isomatter-labs/pulse/README.md

# pulse
A simple power supply / battery box / UPS for many applications.
