isomatter-labs/pulse/pulse-bom.ods

Sheet: Configuration Lookup
 |  |  |  |  |  |  | Assembly fee pct: | 50.00% |  |  | USB Port | Charging Circuit | 3v3 Regulator | 5v regulator | 12v regualtor | 24v regulator
 |  |  |  |  |  |  | Overhead pct: | 50.00% |  | Pulse- | U | C | 3 | 5 | 1 | 2
 |  |  |  |  |  |  | Shipping $: | 3
 |  |  |  |  |  |  |  | with assembly fee | with shipping only
pulse- |  |  |  |  |  | 2 | 2.439563333333333 | 8.4890175 | 6.659345
pulse- |  |  |  |  | 1 |  | 2.439563333333333 | 8.4890175 | 6.659345
pulse- |  |  |  |  | 1 | 2 | 2.870876666666666 | 9.4594725 | 7.306315
pulse- |  |  |  | 5 |  |  | 2.439563333333333 | 8.4890175 | 6.659345
pulse- |  |  |  | 5 |  | 2 | 2.870876666666666 | 9.4594725 | 7.306315
pulse- |  |  |  | 5 | 1 |  | 2.870876666666666 | 9.4594725 | 7.306315
pulse- |  |  |  | 5 | 1 | 2 | 3.30219 | 10.4299275 | 7.953285
pulse- |  |  | 3 |  |  | 2 | 2.866284166666667 | 9.449139375 | 7.29942625
pulse- |  |  | 3 |  | 1 |  | 2.866284166666667 | 9.449139375 | 7.29942625
pulse- |  |  | 3 |  | 1 | 2 | 3.2975975 | 10.419594375 | 7.94639625
pulse- |  |  | 3 | 5 |  |  | 2.866284166666667 | 9.449139375 | 7.29942625
pulse- |  |  | 3 | 5 |  | 2 | 3.2975975 | 10.419594375 | 7.94639625
pulse- |  |  | 3 | 5 | 1 |  | 3.2975975 | 10.419594375 | 7.94639625
pulse- |  |  | 3 | 5 | 1 | 2 | 3.728910833333333 | 11.390049375 | 8.59336625
pulse- |  | C |  |  |  | 2 | 3.076203333333333 | 9.9214575 | 7.614305
pulse- |  | C |  |  | 1 |  | 3.076203333333333 | 9.9214575 | 7.614305
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
pulse- | U | C | 3 | 5 |  | 2 | 4.027703499999999 | 12.062332875 | 9.04155525
pulse- | U | C | 3 | 5 | 1 |  | 4.027703499999999 | 12.062332875 | 9.04155525
pulse- | U | C | 3 | 5 | 1 | 2 | 4.459016833333333 | 13.032787875 | 9.68852525

Sheet: Configuration
All Configs |  |  |  | V varies wildly with qty | 2.00825
PCB |  |  |  | 2
J4 | 1x5 | 2.54mm Male | 1x5_2.54mm Male | 0.00825
USB Port |  |  |  |  | 0.093466
F1 | 1.5A | 0805 | 1.5A_0805 | 0.08399999999999999
R1 | 5k1 | 0805 | 5k1_0805 | 0.002258
R2 | 5k1 | 0805 | 5k1_0805 | 0.002258
J1 | 1x1 | 2.54mm Male | 1x1_2.54mm Male | 0.00165
J2 | 1x1 | 2.54mm Male | 1x1_2.54mm Male | 0.00165
J3 | 1x1 | 2.54mm Male | 1x1_2.54mm Male | 0.00165
Battery Charger |  |  |  |  | 0.63664
U1 | BQ2409X | MSOP-10-EP | BQ2409X_MSOP-10-EP | 0.6
C1 | 1u | 0805 | 1u_0805 | 0.01311
R3 | 540R | 0805 | 540R_0805 | 0.002258
R4 | 2k | 0805 | 2k_0805 | 0.002258
R5 | 100k | 0805 | 100k_0805 | 0.002258
R6 | 1k5 | 0805 | 1k5_0805 | 0.002258
R7 | 1k5 | 0805 | 1k5_0805 | 0.002258
D1 | Red | 1206 | Red_1206 | 0.005653333333333334
D2 | Blue | 1206 | Blue_1206 | 0.006586666666666667
3v3 Regulator
U2 | 34063 | SOIC-8 | 34063_SOIC-8 | 0.0504 | 0.4267208333333333
Q1 | PMOS 3A | GSD SOT-23 | PMOS 3A_ GSD SOT-23 | 0.012960000000000001
C2 | 100uF 6v | 1206 | 100uF 6v_1206 | 0.0378
C6 | 470pF | 0805 | 470pF_0805 | 0.0089675
C10 | 470uF 35v | 10mm 5mm radial | 470uF 35v_10mm 5mm radial | 0.07200000000000001
R8 | 10k | 0805 | 10k_0805 | 0.002258
R9 | 1k | 0805 | 1k_0805 | 0.002258
R16 | 0R22 1.5A | 0805 | 0R22 1.5A_0805 | 0.004
R26 | 5k6 | 0805 | 5k6_0805 | 0.002258
R27 | 3k3 | 0805 | 3k3_0805 | 0.002258
L4 | 220uH 1.5A | SRR1280 | 220uH 1.5A_SRR1280 | 0.162
D3 | 1.5A Schottky | SOD-123F | 1.5A Schottky_SOD-123F | 0.06
J9 | 1x1 | 2.54mm Male | 1x1_2.54mm Male | 0.00165
R31 | 1k | 0805 | 1k_0805 | 0.002258
D10 | Red | 1206 | Red_1206 | 0.005653333333333334
5v Regulator
U3 | 34063 | SOIC-8 | 34063_SOIC-8 | 0.0504 | 0.4313133333333333
Q2 | PMOS 3A | GSD SOT-23 | PMOS 3A_ GSD SOT-23 | 0.012960000000000001
C3 | 100uF 6v | 1206 | 100uF 6v_1206 | 0.0378
C7 | 1500pf | 0805 | 1500pf_0805 | 0.013560000000000001
C11 | 470uF 35v | 10mm 5mm radial | 470uF 35v_10mm 5mm radial | 0.07200000000000001
R10 | 10k | 0805 | 10k_0805 | 0.002258
R11 | 1k | 0805 | 1k_0805 | 0.002258
R17 | 0R22 1.5A | 0805 | 0R22 1.5A_0805 | 0.004
R20 | 10k | 0805 | 10k_0805 | 0.002258
R21 | 3k3 | 0805 | 3k3_0805 | 0.002258
L1 | 220uH 1.5A | SRR1280 | 220uH 1.5A_SRR1280 | 0.162
D4 | 1.5A Schottky | SOD-123F | 1.5A Schottky_SOD-123F | 0.06
J12 | 1x1 | 2.54mm Male | 1x1_2.54mm Male | 0.00165
R30 | 1k5 | 0805 | 1k5_0805 | 0.002258
D9 | Red | 1206 | Red_1206 | 0.005653333333333334
12v Regulator
U4 | 34063 | SOIC-8 | 34063_SOIC-8 | 0.0504 | 0.4313133333333333
Q3 | PMOS 3A | GSD SOT-23 | PMOS 3A_ GSD SOT-23 | 0.01296
C4 | 100uF 6v | 1206 | 100uF 6v_1206 | 0.0378
C8 | 1500pf | 0805 | 1500pf_0805 | 0.01356
C12 | 470uF 35v | 10mm 5mm radial | 470uF 35v_10mm 5mm radial | 0.072
R12 | 10k | 0805 | 10k_0805 | 0.002258
R13 | 1k | 0805 | 1k_0805 | 0.002258
R18 | 0R22 1.5A | 0805 | 0R22 1.5A_0805 | 0.004
R22 | 30k | 0805 | 30k_0805 | 0.002258
R23 | 3k3 | 0805 | 3k3_0805 | 0.002258
L2 | 220uH 1.5A | SRR1280 | 220uH 1.5A_SRR1280 | 0.162
D5 | 1.5A Schottky | SOD-123F | 1.5A Schottky_SOD-123F | 0.06
J10 | 1x1 | 2.54mm Male | 1x1_2.54mm Male | 0.00165
R28 | 3k3 | 0805 | 3k3_0805 | 0.002258
D7 | Red | 1206 | Red_1206 | 0.0056533333333333
24v Regulator
U5 | 34063 | SOIC-8 | 34063_SOIC-8 | 0.0504 | 0.4313133333333333
Q4 | PMOS 3A | GSD SOT-23 | PMOS 3A_ GSD SOT-23 | 0.01296
C5 | 100uF 6v | 1206 | 100uF 6v_1206 | 0.0378
C9 | 1500pf | 0805 | 1500pf_0805 | 0.01356
C13 | 470uF 35v | 10mm 5mm radial | 470uF 35v_10mm 5mm radial | 0.072
R14 | 10k | 0805 | 10k_0805 | 0.002258
R15 | 1k | 0805 | 1k_0805 | 0.002258
R19 | 0R22 1.5A | 0805 | 0R22 1.5A_0805 | 0.004
R24 | 56k | 0805 | 56k_0805 | 0.002258
R25 | 3k | 0805 | 3k_0805 | 0.002258
L3 | 220uH 1.5A | SRR1280 | 220uH 1.5A_SRR1280 | 0.162
D6 | 1.5A Schottky | SOD-123F | 1.5A Schottky_SOD-123F | 0.06
J11 | 1x1 | 2.54mm Male | 1x1_2.54mm Male | 0.00165
R29 | 6k8 | 0805 | 6k8_0805 | 0.002258
D8 | Red | 1206 | Red_1206 | 0.0056533333333333

Sheet: Part Table
part | unit cost | min cost | comes with | link
1x5_2.54mm Male | 0.00825 | 0.66 | 80 | https://www.aliexpress.com/item/32963302159.html
1x1_2.54mm Male | 0.00165 | 0.66 | 400 | https://www.aliexpress.com/item/32963302159.html
1.5A_0805 | 0.084 | 1.68 | 20 | https://www.aliexpress.com/item/4000233270360.html
100k_0805 | 0.002258 | 11.29 | 5000 | https://www.aliexpress.com/item/4000569518897.html
2k_0805 | 0.002258 | 11.29 | 5000 | https://www.aliexpress.com/item/4000569518897.html
5k1_0805 | 0.002258 | 11.29 | 5000 | https://www.aliexpress.com/item/4000569518897.html
540R_0805 | 0.002258 | 11.29 | 5000 | https://www.aliexpress.com/item/4000569518897.html
1k5_0805 | 0.002258 | 11.29 | 5000 | https://www.aliexpress.com/item/4000569518897.html
10k_0805 | 0.002258 | 11.29 | 5000 | https://www.aliexpress.com/item/4000569518897.html
1k_0805 | 0.002258 | 11.29 | 5000 | https://www.aliexpress.com/item/4000569518897.html
5k6_0805 | 0.002258 | 11.29 | 5000 | https://www.aliexpress.com/item/4000569518897.html
3k3_0805 | 0.002258 | 11.29 | 5000 | https://www.aliexpress.com/item/4000569518897.html
BQ2409X_MSOP-10-EP | 0.6 | 3 | 5 | https://www.aliexpress.com/item/32809893346.html
1u_0805 | 0.01311 | 26.22 | 2000 | https://www.aliexpress.com/item/32998534731.html
Red_1206 | 0.0056533333333 | 16.96 | 3000 | https://www.aliexpress.com/item/32981589685.html
Blue_1206 | 0.0065866666667 | 19.76 | 3000 | https://www.aliexpress.com/item/32981589685.html
34063_SOIC-8 | 0.0504 | 5.04 | 100 | https://www.aliexpress.com/item/32328511770.html
PMOS 3A_ GSD SOT-23 | 0.01296 | 38.88 | 3000 | https://www.aliexpress.com/item/33025865729.html
100uF 6v_1206 | 0.0378 | 3.78 | 100 | https://www.aliexpress.com/item/32880416347.html
470pF_0805 | 0.0089675 | 35.87 | 4000 | https://www.aliexpress.com/item/32998534731.html
470uF 35v_10mm 5mm radial | 0.072 | 7.2 | 100 | https://www.aliexpress.com/item/32526581314.html
0R22 1.5A_0805 | 0.004 | 20 | 5000 | https://www.aliexpress.com/item/32839944752.html
220uH 1.5A_SRR1280 | 0.162 | 1.62 | 10 | https://www.aliexpress.com/item/4000167007649.html
1.5A Schottky_SOD-123F | 0.06 | 6 | 100 | https://www.aliexpress.com/item/32254433042.html
1500pf_0805 | 0.01356 | 54.24 | 4000 | https://www.aliexpress.com/item/33000119708.html
56k_0805 | 0.002258 | 11.29 | 5000 | https://www.aliexpress.com/item/4000569518897.html
3k_0805 | 0.002258 | 11.29 | 5000 | https://www.aliexpress.com/item/4000569518897.html
6k8_0805 | 0.002258 | 11.29 | 5000 | https://www.aliexpress.com/item/4000569518897.html
30k_0805 | 0.002258 | 11.29 | 5000 | https://www.aliexpress.com/item/4000569518897.html

Sheet: digikey
Total @1k | 15.23878 | Total @1 | 32.03 | How many regulators? (rough cost overest) | 4
 | Value | cost at 1k | Cost at 1 | Qty | Line Cost @1k | Line Cost @1 | Link
PCB |  | 0.362 | 3.62 | 1 | 0.362 | 3.62 | https://cart.jlcpcb.com/quote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
BT1 | 18650 button cell | 5.95 | 5.95 | 1 | 5.95 | 5.95 | https://www.digikey.com/product-detail/en/tinycircuits/ASR00050/1832-1050-ND/9808766
C1 | 1u | 0.01579 | 0.1 | 1 | 0.01579 | 0.1 | https://www.digikey.com/product-detail/en/samsung-electro-mechanics/CL21B105KOFNNNG/1276-6471-1-ND/5958099
> C2-C5 | CL31A107MQHNNNE | 0.16989 | 0.58 | 4 | 0.67956 | 2.32 | https://www.digikey.com/product-detail/en/samsung-electro-mechanics/CL31A107MQHNNNE/1276-1782-1-ND/3889868
C6 | 470pF | 0.01319 | 0.1 | 1 | 0.01319 | 0.1 | https://www.digikey.com/product-detail/en/samsung-electro-mechanics/CL21B471KBANNNC/1276-1300-1-ND/3889386
> C7-C9 | 1500pF | 0.01355 | 0.1 | 3 | 0.04065 | 0.3 | https://www.digikey.com/product-detail/en/samsung-electro-mechanics/CL21B152KBANNNC/1276-1794-1-ND/3889880
> C10-C13 | 470uF | 0.154 | 0.45 | 4 | 0.616 | 1.8 | https://www.digikey.com/product-detail/en/panasonic-electronic-components/ECA-1VM471/P5168-ND/245027
D1 | Power Good LED | 0.1 | 0.3 | 1 | 0.1 | 0.3
D2 | Charging Active LED | 0.1 | 0.3 | 1 | 0.1 | 0.3
> D3-D6 | NRVTS260ESFT3G | 0.07268 | 0.34 | 4 | 0.29072 | 1.36 | https://www.digikey.com/product-detail/en/on-semiconductor/NRVTS260ESFT3G/NRVTS260ESFT3GOSCT-ND/9087444
D7 | 12v LED | 0.1 | 0.3 | 1 | 0.1 | 0.3
D8 | 24v LED | 0.1 | 0.3 | 1 | 0.1 | 0.3
D9 | 5v LED | 0.1 | 0.3 | 1 | 0.1 | 0.3
D10 | 3v3 LED | 0.1 | 0.3 | 1 | 0.1 | 0.3
F1 | 1.5A | 0.17784 | 0.33 | 1 | 0.17784 | 0.33 | https://www.digikey.com/product-detail/en/bel-fuse-inc/0ZCK0100FF2E/507-1815-1-ND/4156258
J1-J3, J5-J12 | 2.54mm header 1x1 | 0.01486 | 0.03 | 11 | 0.16346 | 0.33 | https://www.digikey.com/product-detail/en/sullins-connector-solutions/PREC001SAAN-RC/S1012EC-01-ND/2774853
J4 | 2.54mm header 1x5 | 0.04009 | 0.1 | 1 | 0.04009 | 0.1 | https://www.digikey.com/product-detail/en/adam-tech/PH1-05-UA/2057-PH1-05-UA-ND/9830343
J13 | USB4085-GF-A_REVA | 0.9656 | 1.37 | 1 | 0.9656 | 1.37 | https://www.digikey.com/product-detail/en/gct/USB4085-GF-A/2073-USB4085-GF-ACT-ND/9859733
> L1-L4 | SRR1280-221K | 0.8378 | 1.25 | 4 | 3.3512 | 5 | https://www.digikey.com/product-detail/en/bourns-inc/SRR1280-221K/SRR1280-221KLCT-ND/2127436
> Q1-Q4 | DMP3099L-7 | 0.06969 | 0.33 | 4 | 0.27876 | 1.32 | https://www.digikey.com/product-detail/en/diodes-incorporated/DMP3099L-7/DMP3099L-7DICT-ND/5218217
> R1, R2 | 5k1 | 0.02 | 0.1 | 2 | 0.04 | 0.2
R3 | 540R | 0.02 | 0.1 | 1 | 0.02 | 0.1
R4 | 2k | 0.02 | 0.1 | 1 | 0.02 | 0.1
R5 | 100k | 0.02 | 0.1 | 1 | 0.02 | 0.1
> R6, R7, R30 | 1k5 | 0.02 | 0.1 | 3 | 0.06 | 0.3
> R8, R10, R12, R14, R20 | 10k | 0.02 | 0.1 | 5 | 0.1 | 0.5
> R9, R11, R13, R15, R31 | 1k | 0.02 | 0.1 | 5 | 0.1 | 0.5
> R16-R19 | 0R22 | 0.02 | 0.1 | 4 | 0.08 | 0.4
R22 | 29k | 0.02 | 0.1 | 1 | 0.02 | 0.1
R24 | 60k | 0.02 | 0.1 | 1 | 0.02 | 0.1
R26 | 5k6 | 0.02 | 0.1 | 1 | 0.02 | 0.1
> R21, R23, R25, R27, R28 | 3k3 | 0.02 | 0.1 | 5 | 0.1 | 0.5
R29 | 6k8 | 0.02 | 0.1 | 1 | 0.02 | 0.1
SW1 | Power Switch |  |  |  | 0 | 0
U1 | BQ2409X | 0.546 | 1.29 | 1 | 0.546 | 1.29 | https://www.digikey.com/product-detail/en/texas-instruments/BQ24092DGQR/296-41204-1-ND/5222660
> U2-U5 | MC34063AD | 0.13198 | 0.46 | 4 | 0.52792 | 1.84 | https://www.digikey.com/product-detail/en/diodes-incorporated/AZ34063UMTR-G1/AZ34063UMTR-G1DICT-ND/4505211
