isomatter-labs/pulse/pulse.kicad_pcb

## KiCad design pulse.kicad_pcb (2020-03-19)

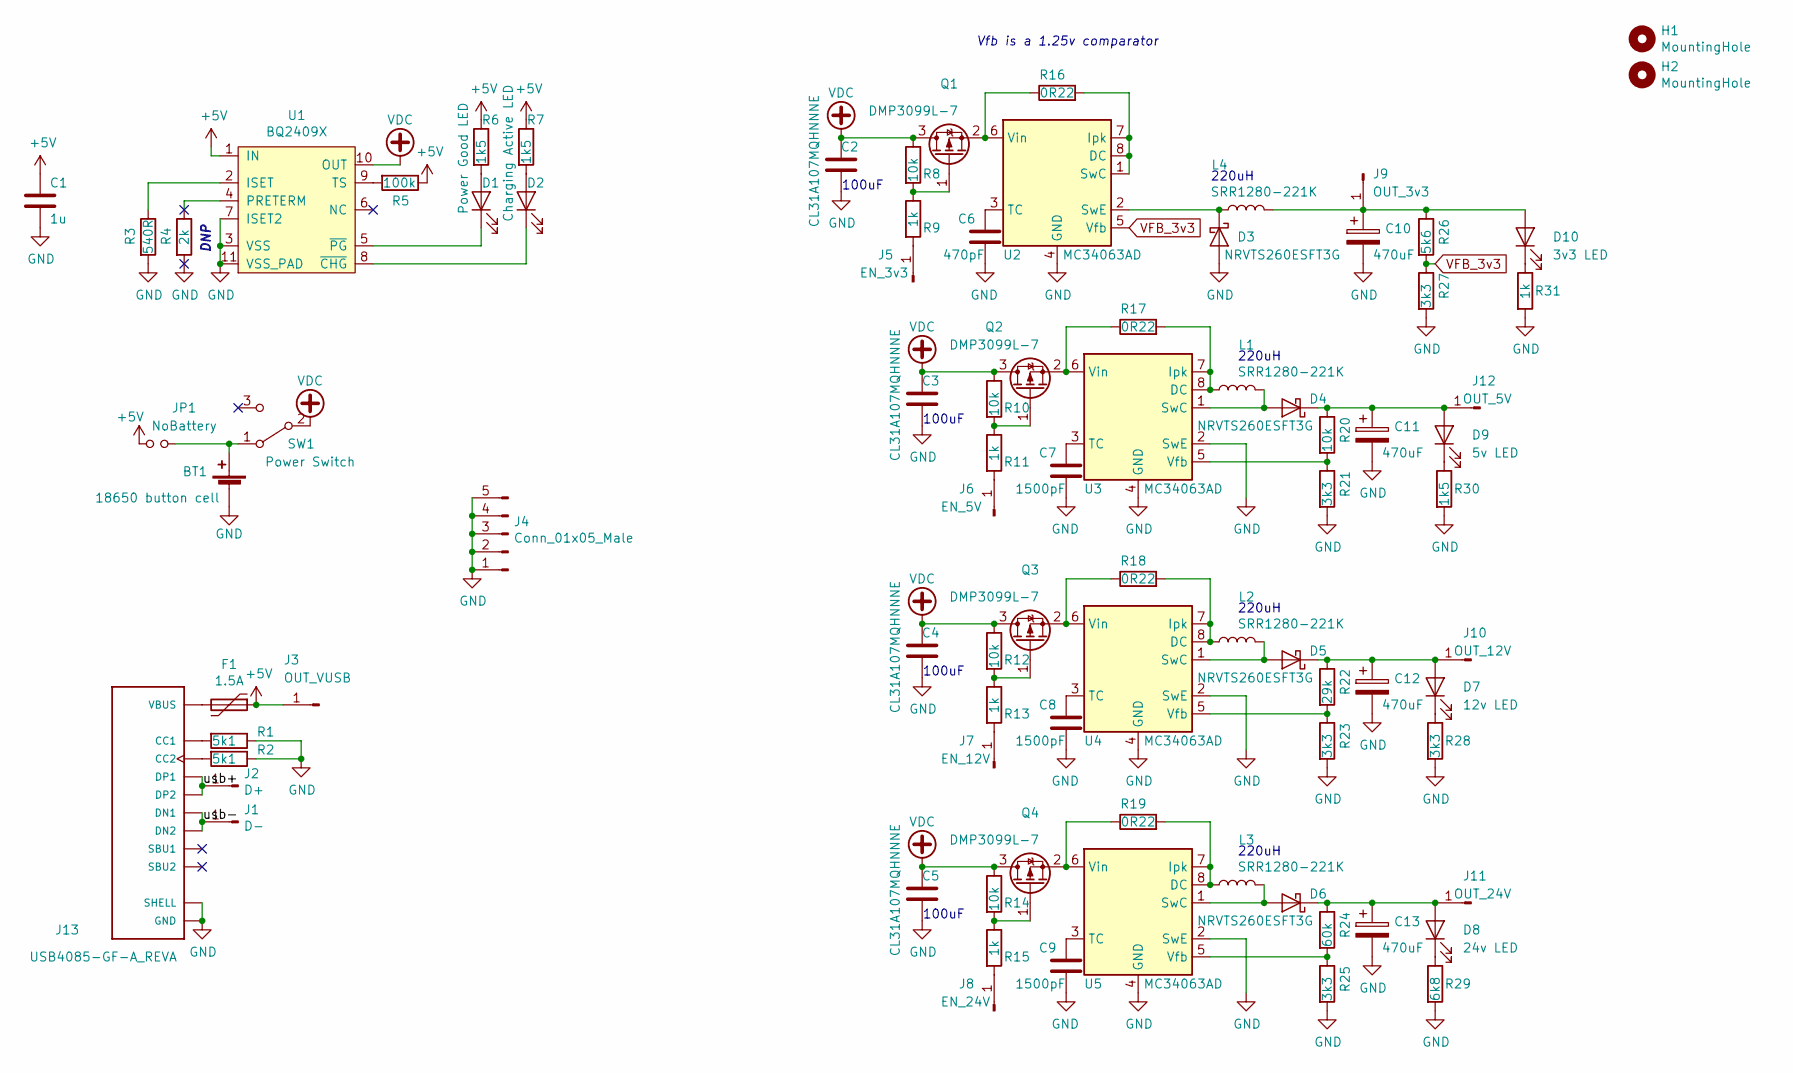
[picture p1: schematic pulse.sch]

Parts:
BT1: 18650 button cell; BatteryHolder_MPD_BH-18650-PC2
C1: 1u; C_0805_2012Metric
C2, C3, C4, C5: CL31A107MQHNNNE; C_1206_3216Metric
C6: 470pF; C_0805_2012Metric
C7, C8, C9: 1500pF; C_0805_2012Metric
C10, C11, C12, C13: 470uF; CP_Radial_D10.0mm_P5.00mm
D1: Power Good LED; LED_1206_3216Metric
D2: Charging Active LED; LED_1206_3216Metric
D3, D4, D5, D6: NRVTS260ESFT3G; D_SOD-123F
D7: 12v LED; LED_1206_3216Metric
D8: 24v LED; LED_1206_3216Metric
D9: 5v LED; LED_1206_3216Metric
D10: 3v3 LED; LED_1206_3216Metric
F1: 1.5A; C_0805_2012Metric
H1, H2: MountingHole; MountingHole_3.2mm_M3
J1: D-; PinHeader_1x01_P2.54mm_Vertical
J2: D+; PinHeader_1x01_P2.54mm_Vertical
J3: OUT_VUSB; PinHeader_1x01_P2.54mm_Vertical
J4: Conn_01x05_Male; PinHeader_1x05_P2.54mm_Vertical
J5: EN_3v3; PinHeader_1x01_P2.54mm_Vertical
J6: EN_5V; PinHeader_1x01_P2.54mm_Vertical
J7: EN_12V; PinHeader_1x01_P2.54mm_Vertical
J8: EN_24V; PinHeader_1x01_P2.54mm_Vertical
J9: OUT_3v3; PinHeader_1x01_P2.54mm_Vertical
J10: OUT_12V; PinHeader_1x01_P2.54mm_Vertical
J11: OUT_24V; PinHeader_1x01_P2.54mm_Vertical
J12: OUT_5V; PinHeader_1x01_P2.54mm_Vertical
J13: USB4085-GF-A_REVA; GCT_USB4085-GF-A_REVA
JP1: NoBattery; SolderJumper-2_P1.3mm_Open_Pad1.0x1.5mm
L1, L2, L3, L4: SRR1280-221K; L_Bourns_SRR1208
Q1, Q2, Q3, Q4: DMP3099L-7; SOT-23
R1, R2: 5k1; R_0805_2012Metric
R3: 540R; R_0805_2012Metric
R4: 2k; R_0805_2012Metric
R5: 100k; R_0805_2012Metric
R6, R7, R30: 1k5; R_0805_2012Metric
R8, R10, R12, R14, R20: 10k; R_0805_2012Metric
R9, R11, R13, R15, R31: 1k; R_0805_2012Metric
R16, R17, R18, R19: 0R22; R_1206_3216Metric
R21, R23, R25, R27, R28: 3k3; R_0805_2012Metric
R22: 29k; R_0805_2012Metric
R24: 60k; R_0805_2012Metric
R26: 5k6; R_0805_2012Metric
R29: 6k8; R_0805_2012Metric
SW1: Power Switch; PinHeader_1x03_P2.54mm_Vertical
U1: BQ2409X; MSOP-10-1EP_3x3mm_P0.5mm_EP1.68x1.88mm
U2, U3, U4, U5: MC34063AD; SOIC-8_3.9x4.9mm_P1.27mm

Connections:
+5V: C1.1, F1.1, J3.1, JP1.1, R5.1, R6.1, R7.1, U1.1 (IN)
/usb+: J2.1, J13.A6 (DP1), J13.B6 (DP2)
/usb-: J1.1, J13.A7 (DN1), J13.B7 (DN2)
GND: BT1.2 (-), C1.2, C2.2, C3.2, C4.2, C5.2, C6.2, C7.2, C8.2, C9.2, C10.2, C11.2, C12.2, C13.2, D3.2 (A), J4.1, J4.2, J4.3, J4.4, J4.5, J13.A1 (GND), J13.A12 (GND), J13.B1 (GND), J13.B12 (GND), J13.P1 (SHELL), J13.P2 (SHELL), J13.P3 (SHELL), J13.P4 (SHELL), R1.1, R2.1, R3.2, R4.2, R21.2, R23.2, R25.2, R27.2, R28.2, R29.2, R30.2, R31.2, U1.3 (VSS), U1.7 (ISET2), U1.11 (VSS_PAD), U2.4 (GND), U3.2 (SwE), U3.4 (GND), U4.2 (SwE), U4.4 (GND), U5.2 (SwE), U5.4 (GND)
unnamed: BT1.1 (+), JP1.2, SW1.1 (A)
unnamed: C6.1, U2.3 (TC)
unnamed: C7.1, U3.3 (TC)
unnamed: C8.1, U4.3 (TC)
unnamed: C9.1, U5.3 (TC)
unnamed: C10.1, D10.2 (A), J9.1, L4.2, R26.1
unnamed: C11.1, D4.1 (K), D9.2 (A), J12.1, R20.1
unnamed: C12.1, D5.1 (K), D7.2 (A), J10.1, R22.1
unnamed: C13.1, D6.1 (K), D8.2 (A), J11.1, R24.1
unnamed: D1.1 (K), U1.5 (~PG)
unnamed: D1.2 (A), R6.2
unnamed: D2.1 (K), U1.8 (~CHG)
unnamed: D2.2 (A), R7.2
unnamed: D3.1 (K), L4.1, U2.2 (SwE)
unnamed: D4.2 (A), L1.2, U3.1 (SwC)
unnamed: D5.2 (A), L2.2, U4.1 (SwC)
unnamed: D6.2 (A), L3.2, U5.1 (SwC)
unnamed: D7.1 (K), R28.1
unnamed: D8.1 (K), R29.1
unnamed: D9.1 (K), R30.1
unnamed: D10.1 (K), R31.1
unnamed: F1.2, J13.A4 (VBUS), J13.A9 (VBUS), J13.B4 (VBUS), J13.B9 (VBUS)
unnamed: J5.1, R9.2
unnamed: J6.1, R11.2
unnamed: J7.1, R13.2
unnamed: J8.1, R15.2
unnamed: J13.A5 (CC1), R1.2
unnamed: J13.B5 (CC2), R2.2
unnamed: L1.1, R17.2, U3.7 (Ipk), U3.8 (DC)
unnamed: L2.1, R18.2, U4.7 (Ipk), U4.8 (DC)
unnamed: L3.1, R19.2, U5.7 (Ipk), U5.8 (DC)
unnamed: Q1.1 (G), R8.2, R9.1
unnamed: Q1.2 (S), R16.1, U2.6 (Vin)
unnamed: Q2.1 (G), R10.2, R11.1
unnamed: Q2.2 (S), R17.1, U3.6 (Vin)
unnamed: Q3.1 (G), R12.2, R13.1
unnamed: Q3.2 (S), R18.1, U4.6 (Vin)
unnamed: Q4.1 (G), R14.2, R15.1
unnamed: Q4.2 (S), R19.1, U5.6 (Vin)
unnamed: R3.1, U1.2 (ISET)
unnamed: R4.1, U1.4 (PRETERM)
unnamed: R5.2, U1.9 (TS)
unnamed: R16.2, U2.1 (SwC), U2.7 (Ipk), U2.8 (DC)
unnamed: R20.2, R21.1, U3.5 (Vfb)
unnamed: R22.2, R23.1, U4.5 (Vfb)
unnamed: R24.2, R25.1, U5.5 (Vfb)
VDC: C2.1, C3.1, C4.1, C5.1, Q1.3 (D), Q2.3 (D), Q3.3 (D), Q4.3 (D), R8.1, R10.1, R12.1, R14.1, SW1.2 (B), U1.10 (OUT)
VFB_3v3: R26.2, R27.1, U2.5 (Vfb)

Notes on the sheet:
DNP
100uF
220uH
Vfb is a 1.25v comparator

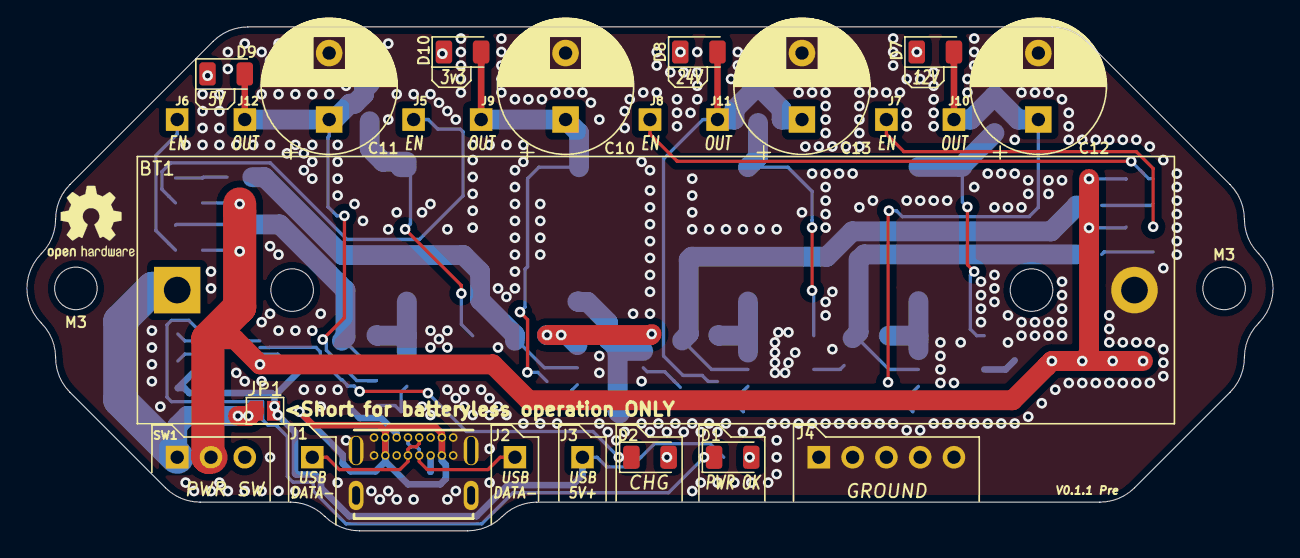
[picture p2: board pulse.kicad_pcb from above]

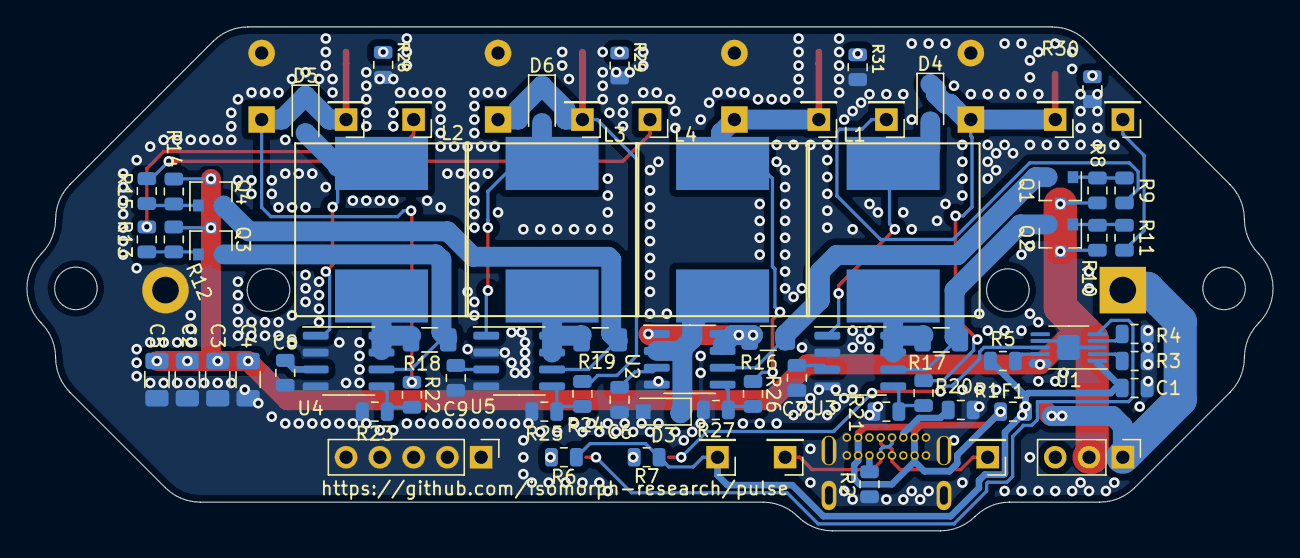
[picture p3: board pulse.kicad_pcb from below]

Board: 2 copper layers, 93.7 x 37.9 mm, 86 parts (71 on the bottom side), 52 nets.
