isomatter-labs/pulse/(commit log)

2020-03-17 Add pre-git work
    [pulse.kicad_pcb, pulse.sch]
2020-03-17 Fix inductor footprint and routing
    [pulse.kicad_pcb, pulse.sch]
2020-03-17 Fix bottom silkscreen and inductor alignment
    [pulse.kicad_pcb]
2020-03-17 Add logos to silkscreen
    [pulse.kicad_pcb]
2020-03-17 Fix overlapping bottom silks
    [pulse.kicad_pcb]
2020-03-17 Export gerbers and drills for V0.0.1
    [pulse-B_Cu.gbr, pulse-B_Mask.gbr, pulse-B_Paste.gbr, pulse-B_SilkS.gbr, pulse-Edge_Cuts.gbr, pulse-F_Cu.gbr, pulse-F_Mask.gbr, pulse-F_Paste.gbr]
2020-03-17 Change timing resistor value for 3v3 buck
    [pulse.sch]
2020-03-17 Add BOM doc
    [pulse-bom.ods]
2020-03-18 Change PCB version Number
    [pulse.kicad_pcb]
2020-03-18 Add batteryless operation jumper pads
    [pulse.kicad_pcb, pulse.sch]
2020-03-19 Change 0.22R shunt resistors to 1206
    [pulse-bom.ods, pulse.kicad_pcb, pulse.sch]
2020-03-19 Change 24vfb resistors to more common value
    [pulse.sch]
2020-03-19 Change 12vfb high resistor to more common value
    [pulse.sch]
2020-03-19 Add aliexpress alternatives for parts in BOM spreadsheet
    [pulse-bom.ods]
2020-03-19 [BOM] add overhead fees to price breakdown
    [pulse-bom.ods]
